shauryarchs/sprinkler-slide-pan-tilt/hardware/main-board/main-board.kicad_pcb

## KiCad design hardware/main-board/main-board.kicad_pcb (2026-11-08)

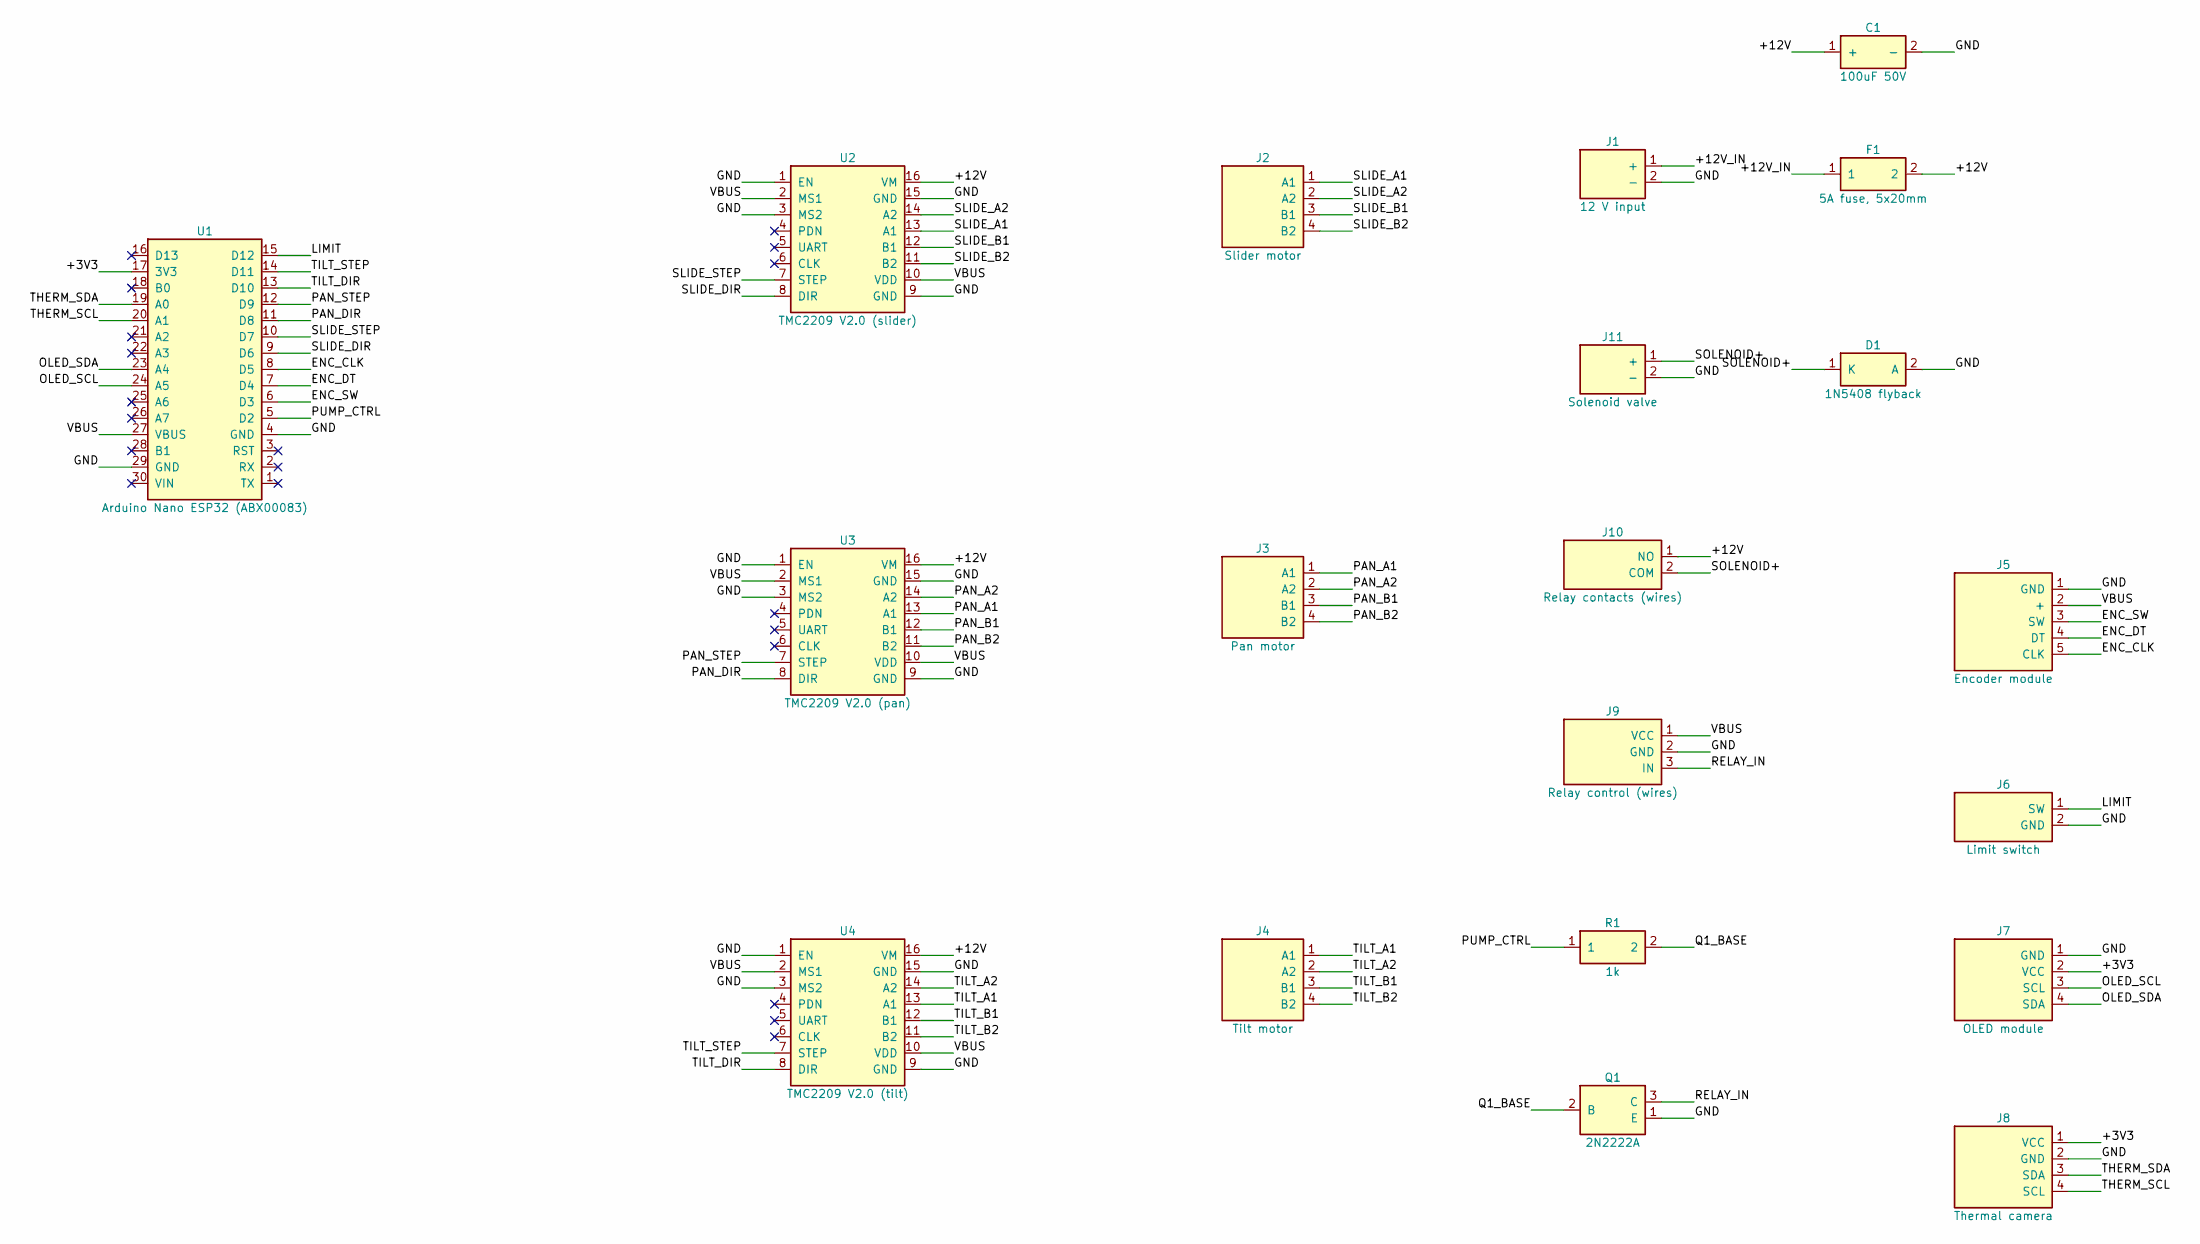
[picture p1: schematic main-board.kicad_sch, EmberSensor sprinkler rig main board]

Parts:
C1: 100uF 50V; CP_Radial_D8.0mm_P3.50mm
D1: 1N5408 flyback; D_DO-201AD_P15.24mm_Horizontal
F1: 5A fuse, 5x20mm; Fuseholder_Clip-5x20mm_Keystone_3517_Inline_P23.11x6.76mm_D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
J1: 12 V input; TerminalBlock_Phoenix_MKDS-1,5-2-5.08_1x02_P5.08mm_Horizont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
J2: Slider motor; TerminalBlock_Phoenix_MKDS-1,5-4-5.08_1x04_P5.08mm_Horizont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
J3: Pan motor; TerminalBlock_Phoenix_MKDS-1,5-4-5.08_1x04_P5.08mm_Horizont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
J4: Tilt motor; TerminalBlock_Phoenix_MKDS-1,5-4-5.08_1x04_P5.08mm_Horizont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
J5: Encoder module; PinHeader_1x05_P2.54mm_Vertical
J6: Limit switch; JST_XH_B2B-XH-A_1x02_P2.50mm_Vertical
J7: OLED module; PinHeader_1x04_P2.54mm_Vertical
J8: Thermal camera; JST_XH_B4B-XH-A_1x04_P2.50mm_Vertical
J9: Relay control (wires); PinHeader_1x03_P2.54mm_Vertical
J10: Relay contacts (wires); TerminalBlock_Phoenix_MKDS-1,5-2-5.08_1x02_P5.08mm_Horizont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
J11: Solenoid valve; TerminalBlock_Phoenix_MKDS-1,5-2-5.08_1x02_P5.08mm_Horizont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
Q1: 2N2222A; TO-92_Inline_Wide
R1: 1k; R_Axial_DIN0207_L6.3mm_D2.5mm_P10.16mm_Horizontal
U1: Arduino Nano ESP32 (ABX00083); Arduino_Nano
U2: TMC2209 V2.0 (slider); Pololu_Breakout-16_15.2x20.3mm
U3: TMC2209 V2.0 (pan); Pololu_Breakout-16_15.2x20.3mm
U4: TMC2209 V2.0 (tilt); Pololu_Breakout-16_15.2x20.3mm

Connections:
/+3V3: J7.2 (VCC), J8.1 (VCC), U1.17 (3V3)
/+12V: C1.1 (+), F1.2, J10.1 (NO), U2.16 (VM), U3.16 (VM), U4.16 (VM)
/+12V_IN: F1.1, J1.1 (+)
/ENC_CLK: J5.5 (CLK), U1.8 (D5)
/ENC_DT: J5.4 (DT), U1.7 (D4)
/ENC_SW: J5.3 (SW), U1.6 (D3)
/GND: C1.2 (-), D1.2 (A), J1.2 (-), J5.1 (GND), J6.2 (GND), J7.1 (GND), J8.2 (GND), J9.2 (GND), J11.2 (-), Q1.1 (E), U1.4 (GND), U1.29 (GND), U2.1 (EN), U2.3 (MS2), U2.9 (GND), U2.15 (GND), U3.1 (EN), U3.3 (MS2), U3.9 (GND), U3.15 (GND), U4.1 (EN), U4.3 (MS2), U4.9 (GND), U4.15 (GND)
/LIMIT: J6.1 (SW), U1.15 (D12)
/OLED_SCL: J7.3 (SCL), U1.24 (A5)
/OLED_SDA: J7.4 (SDA), U1.23 (A4)
/PAN_A1: J3.1 (A1), U3.13 (A1)
/PAN_A2: J3.2 (A2), U3.14 (A2)
/PAN_B1: J3.3 (B1), U3.12 (B1)
/PAN_B2: J3.4 (B2), U3.11 (B2)
/PAN_DIR: U1.11 (D8), U3.8 (DIR)
/PAN_STEP: U1.12 (D9), U3.7 (STEP)
/PUMP_CTRL: R1.1, U1.5 (D2)
/Q1_BASE: Q1.2 (B), R1.2
/RELAY_IN: J9.3 (IN), Q1.3 (C)
/SLIDE_A1: J2.1 (A1), U2.13 (A1)
/SLIDE_A2: J2.2 (A2), U2.14 (A2)
/SLIDE_B1: J2.3 (B1), U2.12 (B1)
/SLIDE_B2: J2.4 (B2), U2.11 (B2)
/SLIDE_DIR: U1.9 (D6), U2.8 (DIR)
/SLIDE_STEP: U1.10 (D7), U2.7 (STEP)
/SOLENOID+: D1.1 (K), J10.2 (COM), J11.1 (+)
/THERM_SCL: J8.4 (SCL), U1.20 (A1)
/THERM_SDA: J8.3 (SDA), U1.19 (A0)
/TILT_A1: J4.1 (A1), U4.13 (A1)
/TILT_A2: J4.2 (A2), U4.14 (A2)
/TILT_B1: J4.3 (B1), U4.12 (B1)
/TILT_B2: J4.4 (B2), U4.11 (B2)
/TILT_DIR: U1.13 (D10), U4.8 (DIR)
/TILT_STEP: U1.14 (D11), U4.7 (STEP)
/VBUS: J5.2 (+), J9.1 (VCC), U1.27 (VBUS), U2.2 (MS1), U2.10 (VDD), U3.2 (MS1), U3.10 (VDD), U4.2 (MS1), U4.10 (VDD)

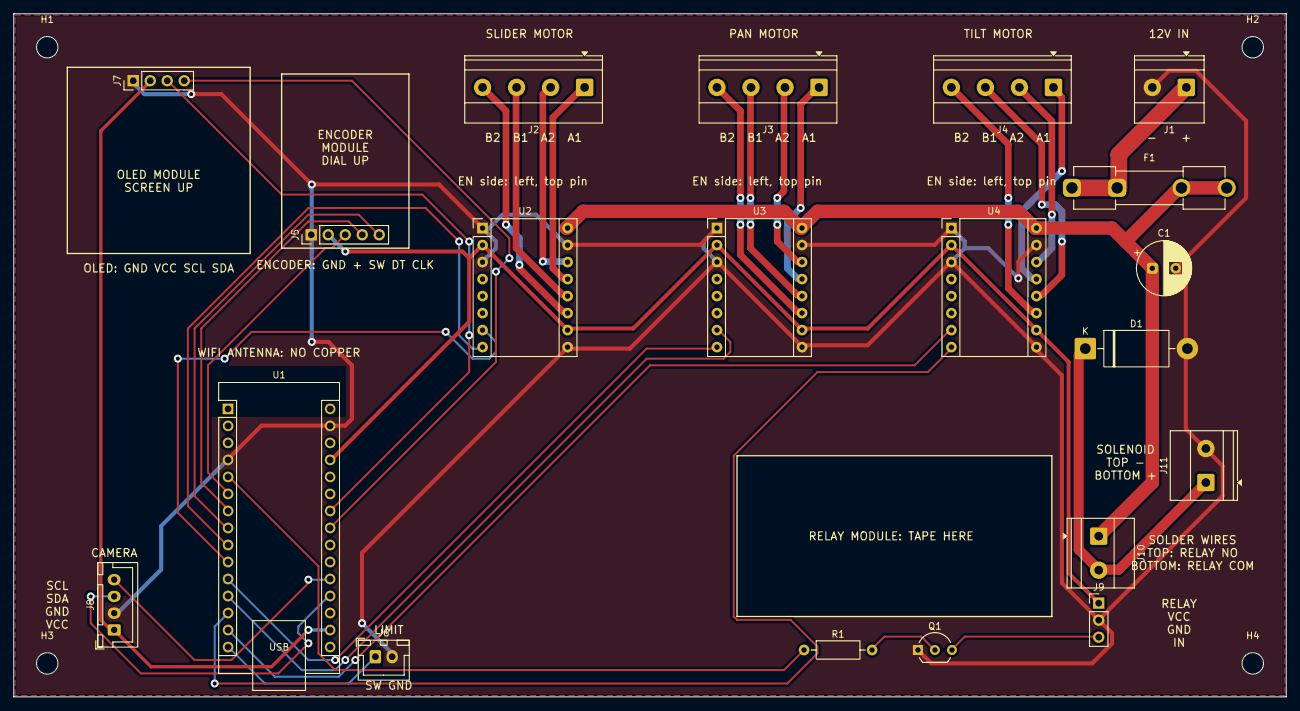
[picture p2: board main-board.kicad_pcb from above]

Board: 2 copper layers, 190.0 x 102.0 mm, 24 parts (0 on the bottom side), 35 nets.

Other parts of the board:
H1, H2, H3, H4: MountingHole_3.2mm_M3
