shauryarchs/sprinkler-slide-pan-tilt/arduino-source/main/main.ino

#include <WiFi.h>
#include <Wire.h>

#include "AppState.h"
#include "AutoAim.h"
#include "CommandPoller.h"
#include "Display.h"
#include "Encoder.h"
#include "LimitSwitch.h"
#include "PanMotor2.h"
#include "SliderMotor1.h"
#include "Sprayer.h"
#include "StatePusher.h"
#include "ThermalCamera.h"
#include "TiltMotor3.h"
#include "secrets.h"

// Pin assignments use Arduino Nano ESP32 silkscreen labels.
// The core resolves them to the right ESP32-S3 GPIOs.
namespace pins {
const int kEncoderSw = D3;
const int kEncoderDt = D4;
const int kEncoderClk = D5;
const int kMotor1Dir = D6;
const int kMotor1Step = D7;
const int kMotor2Dir = D8;
const int kMotor2Step = D9;
const int kMotor3Dir = D10;
const int kMotor3Step = D11;
const int kLimit = D12;
const int kPump = D2;  // 1 kOhm -> NPN transistor -> pump relay IN
}  // namespace pins

// display.display() blocks the main loop for ~30 ms on the I2C frame
// transfer. With timer-driven stepping the motor's pulse stream is
// unaffected by that block, so we can refresh aggressively for snappy
// dial feedback (10 fps -> ~150 ms worst-case visual lag from a click).
const unsigned long kDisplayIntervalMs = 100;

Encoder encoder(pins::kEncoderSw, pins::kEncoderDt, pins::kEncoderClk);
LimitSwitch limitSwitch(pins::kLimit);
SliderMotor1 sliderMotor1(pins::kMotor1Dir, pins::kMotor1Step);
PanMotor2 panMotor2(pins::kMotor2Dir, pins::kMotor2Step);
TiltMotor3 tiltMotor3(pins::kMotor3Dir, pins::kMotor3Step);
Display oled;
StatePusher statePusher(sliderMotor1, panMotor2, tiltMotor3, encoder, limitSwitch);
CommandPoller commandPoller;
// Thermal camera on Wire1 (A0/A1). Reports hotspots to the Serial
// Monitor only — it never moves a motor.
ThermalCamera thermalCamera(tiltMotor3);
// Thermal-guided aiming: slide first, then pan/tilt. ON at boot; acts
// only at the menu. "aim off" in the Serial Monitor disables it until reboot.
AutoAim autoAim(sliderMotor1, panMotor2, tiltMotor3, limitSwitch, thermalCamera);
// Water pump: sprays when auto-aim is on target. ON at boot; "spray off"
// in the Serial Monitor disables it until reboot.
Sprayer sprayer(pins::kPump, autoAim);

// Encoder input: pause auto-aim and stop the water. Remote commands go
// through dispatchRemoteCommand() instead, which keeps a manual spray on.
void notifyUserActivity() {
  autoAim.notifyUserActivity();
  sprayer.notifyUserActivity();
}

// Serial Monitor commands ("aim ...", "spray ...", "pump ..."), one line
// at a time, case-insensitive.
char serialLine[24];
size_t serialLineLen = 0;

void pollSerialCommands() {
  while (Serial.available()) {
    const char c = static_cast<char>(Serial.read());
    if (c != '\n' && c != '\r') {
      if (serialLineLen < sizeof(serialLine) - 1) {
        serialLine[serialLineLen++] = static_cast<char>(tolower(static_cast<unsigned char>(c)));
      }
      continue;
    }
    if (serialLineLen == 0) continue;
    serialLine[serialLineLen] = '\0';
    serialLineLen = 0;
    if (!autoAim.handleCommand(serialLine) && !sprayer.handleCommand(serialLine)) {
      Serial.println("Commands: aim on | aim off | aim status | spray on | spray off | "
                     "spray status | pump on [s] | pump off");
    }
  }
}

// UI state machine: the menu is the resting screen; selecting an item
// hands the encoder over to that motor's control logic. Short-press
// returns to the menu (and stops the active motor).
//
// The Mode enum + the `mode`, `menuIndex`, and `sliderHomed` globals
// live here (in main.ino) but are declared in AppState.h so the
// background StatePusher task can read them without a circular include.
//
// Post-boot-home modes (PanSetup, TiltSetup) are one-shot Pan/Tilt
// zero-position setup states: each click of the encoder steps the
// active motor by kSetupMicroStepsPerClick microsteps; a short-press
// locks the current position as the new "0" reference and advances.
// After Tilt setup the device drops into the menu and these states
// are never re-entered (re-home from Motor 1 does not re-prompt).
Mode mode = Mode::Menu;
int menuIndex = 0;
bool sliderHomed = false;
volatile unsigned long lastSeqAck = 0;
volatile bool pumpActive = false;
const int kMenuItemCount = 4;

// "Patrol" demo mode. The slider and pan motors bounce between their
// soft floor and ceiling; the tilt motor stays put and is only moved
// by the calibration nudgeTilt / zeroTilt commands. The slider's
// speed is driven by the encoder dial — magnitude only, so spinning
// either way speeds it up and dial=0 parks it. Pan has its own
// per-motor magnitude that defaults to 6 and can be retuned at
// runtime by the website via setAllMotorsPanSpeed. Speeds are on
// the dial's [0, kEncoderRange] scale.
int allMotorsPanSpeed = 6;
// Slider speed setpoint applied to the encoder dial on Patrol entry,
// so the carriage starts moving as soon as the user selects the mode
// instead of sitting at zero until they spin the dial.
constexpr int kPatrolInitialSliderSpeed = 18;
// Bounce state per motor in Patrol mode. +1 = heading toward the
// soft ceiling, -1 = heading toward the soft floor.
int allMotorsSliderDir = 1;
int allMotorsPanDir = 1;

// Microsteps applied per encoder click during PanSetup/TiltSetup. The
// motors run at 6400 microsteps/rev = 17.78 microsteps/° with a 1:1
// shaft coupling, so 18 microsteps ≈ 1° per click.
const int kSetupMicroStepsPerClick = 18;

unsigned long lastDisplayUpdateMs = 0;

void enterMenu() {
  sliderMotor1.stop();
  panMotor2.stop();
  tiltMotor3.stop();
  encoder.reset();
  encoder.syncSwState();  // suppress long-press from the press that got us here
  mode = Mode::Menu;
  lastDisplayUpdateMs = 0;
}

void enterMotor1() {
  encoder.reset();
  encoder.syncSwState();
  mode = Mode::Motor1Control;
  lastDisplayUpdateMs = 0;
}

void enterMotor2() {
  encoder.reset();
  encoder.syncSwState();
  mode = Mode::Motor2Control;
  lastDisplayUpdateMs = 0;
}

void enterMotor3() {
  encoder.reset();
  encoder.syncSwState();
  mode = Mode::Motor3Control;
  lastDisplayUpdateMs = 0;
}

void enterAllMotors() {
  encoder.reset();
  // Seed the dial so the slider starts moving immediately. The Patrol
  // handler reads encoder.position() as the slider speed magnitude, so
  // setting it post-reset gives a non-zero starting speed. The user
  // can spin the dial — or the website slider — to override at any
  // time.
  encoder.set(kPatrolInitialSliderSpeed);
  encoder.syncSwState();
  // Pick a starting direction for each bouncing motor that doesn't
  // stall against the ceiling on entry — if already at the ceiling,
  // head back. Tilt doesn't bounce in Patrol mode, so no direction
  // for it.
  allMotorsSliderDir =
      (sliderMotor1.positionSteps() >= SliderMotor1::kMaxPositionSteps) ? -1 : 1;
  allMotorsPanDir =
      (panMotor2.positionSteps() >= PanMotor2::kMaxPositionSteps) ? -1 : 1;
  mode = Mode::AllMotorsControl;
  lastDisplayUpdateMs = 0;
}

// Home the slider, then park the carriage at the middle of the rail so the
// thermal camera can see both sides. Blocking (~16 s for the park move).
void homeAndCenterSlider() {
  oled.showHomingMessage();
  sliderMotor1.home(limitSwitch);
  sliderMotor1.moveToBlocking(SliderMotor1::kCenterPositionSteps, limitSwitch);
  sliderHomed = true;
}

void rehome() {
  // Long-press in Motor1 mode re-homes. Drop the encoder ISR for the
  // duration of homing, then resync after.
  encoder.suspend();
  homeAndCenterSlider();
  encoder.reset();
  encoder.resume();
  encoder.syncSwState();
  lastDisplayUpdateMs = 0;
}

void setup() {
  // USB serial for the thermal camera's "THERMAL ..." status lines.
  // Printing happens on the core-0 thermal task, never the motor loop.
  Serial.begin(115200);
  sprayer.begin();  // pump off before anything else

  limitSwitch.begin();
  sliderMotor1.begin();
  panMotor2.begin();
  tiltMotor3.begin();

  Wire.begin();
  Wire.setClock(400000);
  oled.begin();

  // Motor1 boot homing (then park at the middle of the rail); motor2 has
  // no limit switch so we just trust its mechanical alignment at power-on.
  homeAndCenterSlider();

  encoder.begin();
  encoder.syncSwState();

  // Start Wi-Fi in station mode and kick off the background state-push
  // task. Wi-Fi connect is non-blocking — if the network is down the
  // device keeps working locally; StatePusher's pushOnce() short-circuits
  // when WiFi.status() != WL_CONNECTED, and the next heartbeat just
  // tries again.
  WiFi.mode(WIFI_STA);
  WiFi.begin(WIFI_SSID, WIFI_PASSWORD);
  statePusher.begin(EMBER_API_HOST);
  commandPoller.begin(EMBER_API_HOST);
  thermalCamera.begin();

  // After boot homing, prompt the user to set the Pan and Tilt initial
  // positions before handing control over to the main menu. This runs
  // once per power-up; re-homing later (long-press in Motor 1) does not
  // re-enter setup.
  mode = Mode::PanSetup;
}

void handleMenu() {
  int delta = encoder.consumeDelta();
  if (delta != 0) {
    notifyUserActivity();
    int step = (delta > 0) ? 1 : -1;
    menuIndex = (menuIndex + step + kMenuItemCount) % kMenuItemCount;
  }
  if (encoder.consumeShortPress()) {
    notifyUserActivity();
    switch (menuIndex) {
      case 0: enterMotor1(); break;
      case 1: enterMotor2(); break;
      case 2: enterMotor3(); break;
      case 3: enterAllMotors(); break;
    }
  }
  // Long-press has no meaning in the menu — drain it so it doesn't
  // fire later in motor mode if the user held through the transition.
  encoder.consumeLongPress();
}

void handleMotor1() {
  if (encoder.consumeShortPress()) {
    enterMenu();
    return;
  }
  if (encoder.consumeLongPress()) {
    rehome();
    return;
  }

  int dial = encoder.position();
  sliderMotor1.update(dial, limitSwitch);

  // Auto-reset the dial when pinned at an end of travel so the next
  // click in the opposite direction goes straight into reverse.
  long posSteps = sliderMotor1.positionSteps();
  if (dial > 0 && posSteps >= SliderMotor1::kMaxPositionSteps) {
    encoder.reset();
  } else if (dial < 0 && posSteps <= SliderMotor1::kMinPositionSteps) {
    encoder.reset();
  }
}

void handleMotor2() {
  if (encoder.consumeShortPress()) {
    enterMenu();
    return;
  }
  // Long-press is meaningful only on motor1 — drain it.
  encoder.consumeLongPress();

  int dial = encoder.position();
  panMotor2.update(dial);

  // Same auto-reset idea: at either end of the ±105° range, snap the
  // dial back to 0 so reversing is one click away.
  long posSteps = panMotor2.positionSteps();
  if (dial > 0 && posSteps >= PanMotor2::kMaxPositionSteps) {
    encoder.reset();
  } else if (dial < 0 && posSteps <= PanMotor2::kMinPositionSteps) {
    encoder.reset();
  }
}

void handleMotor3() {
  if (encoder.consumeShortPress()) {
    enterMenu();
    return;
  }
  encoder.consumeLongPress();

  int dial = encoder.position();
  tiltMotor3.update(dial);

  long posSteps = tiltMotor3.positionSteps();
  if (dial > 0 && posSteps >= TiltMotor3::kMaxPositionSteps) {
    encoder.reset();
  } else if (dial < 0 && posSteps <= TiltMotor3::kMinPositionSteps) {
    encoder.reset();
  }
}

void handleAllMotors() {
  if (encoder.consumeShortPress()) {
    enterMenu();
    return;
  }
  // Long-press is unused in this mode — drain so a hold-through-entry
  // doesn't fire later.
  encoder.consumeLongPress();

  // Encoder dial controls the slider's speed magnitude only; the bounce
  // direction is managed below. dial=0 parks the slider; spinning either
  // way speeds it up.
  int dial = encoder.position();
  int sliderSpeed = (dial >= 0) ? dial : -dial;

  // Slider: bounce. Flip direction once the carriage reaches either
  // soft bound; the motor's own update() will already have stopped it
  // there, and the next loop iteration will start it moving back.
  long sliderPos = sliderMotor1.positionSteps();
  if (allMotorsSliderDir > 0 && sliderPos >= SliderMotor1::kMaxPositionSteps) {
    allMotorsSliderDir = -1;
  } else if (allMotorsSliderDir < 0 && sliderPos <= SliderMotor1::kMinPositionSteps) {
    allMotorsSliderDir = 1;
  }
  sliderMotor1.update(allMotorsSliderDir * sliderSpeed, limitSwitch);

  // Pan: bounce between ±105° around the boot reference.
  long panPos = panMotor2.positionSteps();
  if (allMotorsPanDir > 0 && panPos >= PanMotor2::kMaxPositionSteps) {
    allMotorsPanDir = -1;
  } else if (allMotorsPanDir < 0 && panPos <= PanMotor2::kMinPositionSteps) {
    allMotorsPanDir = 1;
  }
  panMotor2.update(allMotorsPanDir * allMotorsPanSpeed);

  // Tilt is intentionally not driven in Patrol mode — it stays put,
  // and is moved only by the calibration nudgeTilt / zeroTilt commands.
}

void handlePanSetup() {
  if (encoder.consumeShortPress()) {
    panMotor2.zeroPosition();
    encoder.reset();
    encoder.syncSwState();
    mode = Mode::TiltSetup;
    lastDisplayUpdateMs = 0;
    return;
  }
  // Long-press has no meaning in setup — drain it.
  encoder.consumeLongPress();

  int delta = encoder.consumeDelta();
  if (delta != 0) {
    panMotor2.stepBy(delta * kSetupMicroStepsPerClick);
  }
}

void handleTiltSetup() {
  if (encoder.consumeShortPress()) {
    tiltMotor3.zeroPosition();
    encoder.reset();
    encoder.syncSwState();
    mode = Mode::Menu;
    lastDisplayUpdateMs = 0;
    return;
  }
  encoder.consumeLongPress();

  int delta = encoder.consumeDelta();
  if (delta != 0) {
    tiltMotor3.stepBy(delta * kSetupMicroStepsPerClick);
  }
}

// Dispatch a command delivered by CommandPoller into the same handlers
// the encoder uses. Runs only on the main loop thread, so it can freely
// touch `mode`, the encoder ISR, etc.
//
// Conflict policy is last-write-wins: a remote `enterMode` takes effect
// immediately even if the user is mid-spin; the next encoder click
// would just transition again. setSliderSpeed re-anchors the encoder
// dial, which the Patrol handler reads on each iteration. We
// intentionally ignore PanSetup / TiltSetup target modes — that flow
// is one-shot at boot and not exposed to the remote.
void dispatchRemoteCommand(const RemoteCommand& cmd) {
  // Any remote command takes priority over auto-aim and stops automatic
  // spraying. A manual spray keeps going so the user can aim while it
  // runs; only pumpOff or Stop (enterMode menu) ends it early.
  autoAim.notifyUserActivity();
  sprayer.notifyRemoteCommand();
  switch (cmd.kind) {
    case RemoteCmdKind::EnterMode:
      switch (cmd.targetMode) {
        case Mode::Menu:
          // The app's and website's Stop button: stop motors and water.
          sprayer.remoteStop();
          enterMenu();
          break;
        case Mode::Motor1Control:    enterMotor1();    break;
        case Mode::Motor2Control:    enterMotor2();    break;
        case Mode::Motor3Control:    enterMotor3();    break;
        case Mode::AllMotorsControl: enterAllMotors(); break;
        default: break;
      }
      break;
    case RemoteCmdKind::Rehome:
      // rehome() suspends the encoder ISR, homes the slider, resumes.
      // Safe to call from any mode; current mode is preserved.
      rehome();
      break;
    case RemoteCmdKind::ZeroPan:
      panMotor2.zeroPosition();
      break;
    case RemoteCmdKind::ZeroTilt:
      tiltMotor3.zeroPosition();
      break;
    case RemoteCmdKind::NudgePan: {
      // Convert signed degrees → microsteps; same math as
      // kSetupMicroStepsPerClick uses. stepBy() bypasses soft bounds
      // — intentional, this mirrors PanSetup mode behavior.
      const long steps =
          (static_cast<long>(cmd.deltaDeg) * PanMotor2::kStepsPerRev) / 360;
      panMotor2.stepBy(static_cast<int>(steps));
      break;
    }
    case RemoteCmdKind::NudgeTilt: {
      const long steps =
          (static_cast<long>(cmd.deltaDeg) * TiltMotor3::kStepsPerRev) / 360;
      tiltMotor3.stepBy(static_cast<int>(steps));
      break;
    }
    case RemoteCmdKind::SetSliderSpeed:
      // The encoder dial is the speed setpoint in every motor mode:
      // signed (sign = direction) for Motor 1/2/3, magnitude for
      // Patrol (direction is the bounce). Re-anchor in all four
      // so the website's signed speed slider works across them.
      // Menu / PanSetup / TiltSetup use the encoder as a navigation
      // delta or a setup nudge, so re-anchoring there would just
      // surprise the user.
      if (mode == Mode::Motor1Control || mode == Mode::Motor2Control ||
          mode == Mode::Motor3Control || mode == Mode::AllMotorsControl) {
        encoder.set(cmd.speed);
      }
      break;
    case RemoteCmdKind::SetAllMotorsPanSpeed:
      // Magnitude only — direction is set by the bounce logic in
      // handleAllMotors(). Clamp to the encoder's positive range so a
      // bad payload can't push the motor past its max step rate.
      allMotorsPanSpeed = constrain(cmd.speed, 0, Encoder::kRange);
      break;
    case RemoteCmdKind::PumpOn:
      // Timed manual run; Sprayer caps it at kRemoteMaxS.
      sprayer.remoteStart(cmd.seconds);
      break;
    case RemoteCmdKind::PumpOff:
      sprayer.remoteStop();
      break;
    default:
      break;
  }
  lastSeqAck = cmd.seq;
}

void loop() {
  encoder.update();
  pollSerialCommands();

  // Drain any commands the CommandPoller task has queued. Bounded by
  // the queue depth (4); typically 0 or 1 per iteration.
  RemoteCommand cmd;
  while (xQueueReceive(commandPoller.queue(), &cmd, 0) == pdTRUE) {
    dispatchRemoteCommand(cmd);
  }

  switch (mode) {
    case Mode::Menu:             handleMenu();      break;
    case Mode::Motor1Control:    handleMotor1();    break;
    case Mode::Motor2Control:    handleMotor2();    break;
    case Mode::Motor3Control:    handleMotor3();    break;
    case Mode::AllMotorsControl: handleAllMotors(); break;
    case Mode::PanSetup:         handlePanSetup();  break;
    case Mode::TiltSetup:        handleTiltSetup(); break;
  }

  // Auto-aim only acts while idle at the menu; motor modes and the boot
  // setup screens own the motors.
  autoAim.update(mode == Mode::Menu);
  sprayer.update();
  pumpActive = sprayer.pumpOn();

  if (millis() - lastDisplayUpdateMs >= kDisplayIntervalMs) {
    switch (mode) {
      case Mode::Menu:
        oled.showMenu(menuIndex);
        break;
      case Mode::Motor1Control:
        oled.showMotor1Status(encoder.position(), sliderMotor1.positionMm(),
                              limitSwitch.engaged());
        break;
      case Mode::Motor2Control:
        oled.showMotor2Status(encoder.position(), panMotor2.positionDegrees());
        break;
      case Mode::Motor3Control:
        oled.showMotor3Status(encoder.position(), tiltMotor3.positionDegrees());
        break;
      case Mode::AllMotorsControl: {
        int dial = encoder.position();
        int sliderSpeed = (dial >= 0) ? dial : -dial;
        oled.showAllMotorsStatus(sliderSpeed,
                                 sliderMotor1.positionMm(),
                                 panMotor2.positionDegrees(),
                                 tiltMotor3.positionDegrees(),
                                 limitSwitch.engaged());
        break;
      }
      case Mode::PanSetup:
        oled.showPanSetupScreen(panMotor2.positionDegrees());
        break;
      case Mode::TiltSetup:
        oled.showTiltSetupScreen(tiltMotor3.positionDegrees());
        break;
    }
    lastDisplayUpdateMs = millis();
  }
}
