shauryarchs/sprinkler-slide-pan-tilt/arduino-source/main/AppState.h

#pragma once

// Application-level state shared between main.ino and StatePusher.
//
// main.ino is the single writer for `mode`, `menuIndex`, and
// `sliderHomed`. StatePusher reads them from its background task. On
// the ESP32-S3, single-word loads of plain integer/enum types are
// atomic across cores, so we don't need a mutex around these reads —
// the reader may see a slightly stale value for one tick, which is
// fine for a state-mirror push.

enum class Mode {
  Menu,
  Motor1Control,
  Motor2Control,
  Motor3Control,
  AllMotorsControl,
  PanSetup,
  TiltSetup,
};

extern Mode mode;
extern int menuIndex;
extern bool sliderHomed;

// Sequence number of the last /api/motor/command the device executed.
// CommandPoller passes this as ?since=<lastSeqAck> when polling so the
// worker only returns newer commands. StatePusher echoes it in its
// push JSON so the website can show "Done" feedback once a command
// has been picked up. Read on core 0 (network task) and written by
// the main loop on core 1; volatile + single-word atomic loads
// suffice.
extern volatile unsigned long lastSeqAck;

// Whether the water pump is running (automatic or manual). Written by
// the main loop after sprayer.update(), read by StatePusher so the app
// can show when water is flowing.
extern volatile bool pumpActive;

// Stable lowercase machine-readable names the website's control page
// keys off (see docs/control.html → MODE_LABELS).
inline const char* modeName(Mode m) {
  switch (m) {
    case Mode::Menu:             return "menu";
    case Mode::Motor1Control:    return "motor1";
    case Mode::Motor2Control:    return "motor2";
    case Mode::Motor3Control:    return "motor3";
    case Mode::AllMotorsControl: return "allmotors";
    case Mode::PanSetup:         return "panSetup";
    case Mode::TiltSetup:        return "tiltSetup";
  }
  return "unknown";
}
