shauryarchs/sprinkler-slide-pan-tilt/arduino-source/main/Display.cpp

#include "Display.h"

namespace {
constexpr int kScreenWidth = 128;
constexpr int kScreenHeight = 64;
}  // namespace

Display::Display(uint8_t addr)
    : display_(kScreenWidth, kScreenHeight, &Wire, -1),
      addr_(addr),
      ok_(false) {}

bool Display::begin() {
  ok_ = display_.begin(SSD1306_SWITCHCAPVCC, addr_);
  if (ok_) {
    display_.clearDisplay();
    display_.setTextColor(SSD1306_WHITE);
  }
  return ok_;
}

void Display::showHomingMessage() {
  if (!ok_) return;
  display_.clearDisplay();
  display_.setTextColor(SSD1306_WHITE);
  display_.setTextSize(2);
  display_.setCursor(0, 0);
  display_.println(F("Homing..."));
  display_.setTextSize(1);
  display_.setCursor(0, 22);
  display_.println(F("Please wait,"));
  display_.setCursor(0, 34);
  display_.println(F("don't press any"));
  display_.setCursor(0, 46);
  display_.println(F("buttons or dials"));
  display_.display();
}

void Display::showMenu(int selection) {
  if (!ok_) return;
  display_.clearDisplay();
  display_.setTextColor(SSD1306_WHITE);
  display_.setTextSize(1);

  display_.setCursor(0, 0);
  display_.println(F("Select Motor:"));

  // Size 1 (6x8 px). Longer names don't fit at size 2 — "> Slider-Motor1"
  // is 15 chars × 12 px = 180 px, well past the 128 px panel. Row pitch
  // tightened to 12 px to fit four items inside the 64 px panel.
  display_.setCursor(0, 14);
  display_.print(selection == 0 ? F("> Slider-Motor1") : F("  Slider-Motor1"));
  display_.setCursor(0, 26);
  display_.print(selection == 1 ? F("> Pan-Motor2") : F("  Pan-Motor2"));
  display_.setCursor(0, 38);
  display_.print(selection == 2 ? F("> Tilt-Motor3") : F("  Tilt-Motor3"));
  display_.setCursor(0, 50);
  display_.print(selection == 3 ? F("> Patrol") : F("  Patrol"));

  display_.display();
}

void Display::showMotor1Status(int dial, long posMm, bool limitEngaged) {
  if (!ok_) return;
  display_.clearDisplay();
  display_.setTextColor(SSD1306_WHITE);
  display_.setTextSize(1);

  display_.setCursor(0, 0);
  display_.println(F("Ember Sensor"));

  display_.setCursor(0, 10);
  display_.println(F("www.embersensor.com"));

  display_.setCursor(0, 22);
  display_.print(F("Dial: "));
  if (dial > 0) display_.print('+');
  display_.print(dial);
  display_.print(' ');
  if (dial > 0) display_.print(F("CW"));
  else if (dial < 0) display_.print(F("CCW"));
  else display_.print(F("STOP"));

  display_.setCursor(0, 33);
  display_.print(F("Pos: "));
  display_.print(posMm);
  display_.print(F(" mm"));

  display_.setCursor(0, 44);
  display_.print(F("Limit: "));
  display_.print(limitEngaged ? F("LOW (hit)") : F("HIGH"));

  display_.setCursor(0, 56);
  display_.print(F("By, Shaurya Varshnay"));

  display_.display();
}

void Display::showMotor2Status(int dial, long posDeg) {
  if (!ok_) return;
  display_.clearDisplay();
  display_.setTextColor(SSD1306_WHITE);
  display_.setTextSize(1);

  display_.setCursor(0, 0);
  display_.println(F("Ember Sensor"));

  display_.setCursor(0, 10);
  display_.println(F("www.embersensor.com"));

  display_.setCursor(0, 22);
  display_.print(F("Dial: "));
  if (dial > 0) display_.print('+');
  display_.print(dial);
  display_.print(' ');
  if (dial > 0) display_.print(F("CW"));
  else if (dial < 0) display_.print(F("CCW"));
  else display_.print(F("STOP"));

  display_.setCursor(0, 33);
  display_.print(F("Pos: "));
  display_.print(posDeg);
  display_.print(F(" deg"));

  display_.setCursor(0, 44);
  display_.print(F("Pan-Motor2 [+/-105]"));

  display_.setCursor(0, 56);
  display_.print(F("By, Shaurya Varshnay"));

  display_.display();
}

void Display::showMotor3Status(int dial, long posDeg) {
  if (!ok_) return;
  display_.clearDisplay();
  display_.setTextColor(SSD1306_WHITE);
  display_.setTextSize(1);

  display_.setCursor(0, 0);
  display_.println(F("Ember Sensor"));

  display_.setCursor(0, 10);
  display_.println(F("www.embersensor.com"));

  display_.setCursor(0, 22);
  display_.print(F("Dial: "));
  if (dial > 0) display_.print('+');
  display_.print(dial);
  display_.print(' ');
  if (dial > 0) display_.print(F("CW"));
  else if (dial < 0) display_.print(F("CCW"));
  else display_.print(F("STOP"));

  display_.setCursor(0, 33);
  display_.print(F("Pos: "));
  display_.print(posDeg);
  display_.print(F(" deg"));

  display_.setCursor(0, 44);
  display_.print(F("Tilt-Motor3 [+/-360]"));

  display_.setCursor(0, 56);
  display_.print(F("By, Shaurya Varshnay"));

  display_.display();
}

namespace {
void renderSetupScreen(Adafruit_SSD1306& display_, const __FlashStringHelper* title,
                       long offsetDeg) {
  display_.clearDisplay();
  display_.setTextColor(SSD1306_WHITE);
  display_.setTextSize(1);

  display_.setCursor(0, 0);
  display_.println(title);

  display_.setCursor(0, 14);
  display_.println(F("Spin to rotate"));

  display_.setCursor(0, 26);
  display_.println(F("Press to set 0"));

  display_.setCursor(0, 44);
  display_.print(F("Offset: "));
  if (offsetDeg > 0) display_.print('+');
  display_.print(offsetDeg);
  display_.print(F(" deg"));

  display_.setCursor(0, 56);
  display_.print(F("By, Shaurya Varshnay"));

  display_.display();
}
}  // namespace

void Display::showPanSetupScreen(long offsetDeg) {
  if (!ok_) return;
  renderSetupScreen(display_, F("Set Pan Start"), offsetDeg);
}

void Display::showTiltSetupScreen(long offsetDeg) {
  if (!ok_) return;
  renderSetupScreen(display_, F("Set Tilt Start"), offsetDeg);
}

void Display::showAllMotorsStatus(int sliderSpeed, long sliderMm, long panDeg,
                                  long tiltDeg, bool limitEngaged) {
  if (!ok_) return;
  display_.clearDisplay();
  display_.setTextColor(SSD1306_WHITE);
  display_.setTextSize(1);

  display_.setCursor(0, 0);
  display_.println(F("Patrol"));

  display_.setCursor(0, 12);
  display_.print(F("Slider: "));
  display_.print(sliderMm);
  display_.print(F(" mm"));

  display_.setCursor(0, 22);
  display_.print(F("Pan:    "));
  display_.print(panDeg);
  display_.print(F(" deg"));

  display_.setCursor(0, 32);
  display_.print(F("Tilt:   "));
  display_.print(tiltDeg);
  display_.print(F(" deg"));

  display_.setCursor(0, 44);
  display_.print(F("Spd: "));
  display_.print(sliderSpeed);
  display_.print(F("  Lmt: "));
  display_.print(limitEngaged ? F("LOW") : F("HI"));

  display_.setCursor(0, 56);
  display_.print(F("By, Shaurya Varshnay"));

  display_.display();
}
