shauryarchs/sprinkler-slide-pan-tilt/(commit log)

2026-04-26 added arduino source for testing
2026-04-26 Add I2C scanner sketch for diagnosing OLED bus issues
2026-04-26 Add button (D4/D5/D6) and pot (A0) motor controls
    - Three buttons with INPUT_PULLUP and 30 ms debounce: D4 CCW, D5 CW, D6 stop
    - Pot on A0 drives speed and direction when motor is IDLE; 25-count deadband
    - Mid-spin direction reversals re-ramp to avoid losing steps
    - Display shows POT/SMOOTH/DANCE/IDLE with speed bar and CW/CCW indicator
    - Boot prints initial button pin states to surface miswiring early
    - OLED redraws throttled to ~10 fps during pot sliding to spare I2C bandwidth
    [main.ino]
2026-04-26 Document button colors in wiring header (D4 blue, D5 green, D6 red)
2026-04-26 Convert pot to positional encoder (1° pot = 1° motor) and add doggy idle art
    - Pot now reports a signed step delta per poll instead of a velocity target;
    motor steps once per delta, so turning the knob rotates the motor 1:1 in
    degrees and stopping the knob stops the motor
    - Pot is still active only when motor is IDLE; setMode() resyncs the pot's
    reference on entry to IDLE so the motor doesn't lurch to catch up with
    pot movement that happened during SMOOTH/DANCE
    - Calibration constants (POT_USABLE_DEG, MOTOR_STEPS_PER_REV) at the top
    of pot.cpp for hardware tuning
    - Display POT screen shows 'synced to knob' subtitle (no longer a speed
    bar — doesn't apply to position tracking)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
    [main.ino]
2026-04-26 Add running dog animation, 10x pot range, 3x smooth speed, THEO label
    - Display: 4-frame running-dog ASCII animation (~7 fps) plays whenever the
    motor is rotating (SMOOTH/DANCE/POT). IDLE keeps the static dog.
    - IDLE label renamed to THEO.
    - Pot: STEPS_PER_FULL_POT 200 -> 2000, so a full knob turn drives ten
    motor revolutions instead of one. Conversion simplified to use the
    step count directly (no degree math). Wiring header updated.
    - Smooth: SMOOTH_DEFAULT_DELAY_US 700 -> 233 us, tripling the default
    CW/CCW step rate.
2026-04-26 Stop pot motor immediately when knob stops turning
    Process pot delta in small batches (8 steps) and re-poll between them
    instead of committing the full delta to a tight step loop. When the pot
    goes stationary, the next pollDelta returns 0 and runPot exits — the
    motor stops within ~one batch (~8 ms) of the user releasing the knob
    instead of running off the remaining backlog. Trade-off: a very fast
    knob sweep can leave the motor a few steps behind the pot's final
    position, since we explicitly do not chase the residual.
2026-04-26 Make STOP button override pot tracking with a latch
    Previously pressing STOP while the pot was driving the motor was a
    no-op (mode was already IDLE). Now STOP latches a potDisabled flag that
    runPot checks each iteration, so the motor stops within one batch
    regardless of whether SMOOTH/DANCE or pot tracking caused the motion.
    - Motor::stopPressed() halts and sets the latch; pressing STOP again
    while already idle toggles the latch back off so the pot can be
    re-engaged without going through SMOOTH first
    - Motor::startSmooth() clears the latch (CW/CCW is an explicit start)
    - Display shows STOP instead of THEO when the latch is on
    - Both serial 's' and the red button route through stopPresse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
2026-04-27 Switch smooth mode to single-interval pulse timing
    - Replace half-period delay + ramp-up with one full-period interval
    - Drop unused setMode() from public Motor API
    - Update comments to reflect TB6600 driver wiring
    [main.ino]
2026-04-27 Add joystick Y-axis control with deflection-based speed
    - New joystick module reads A0, emits up/down/center events with deadband
    - Joystick mirrors CW/CCW/STOP buttons for direction
    - Deflection magnitude maps to step interval via Motor::setSpeedFraction
    - Light push = slow, full push = fast; centered stick leaves speed alone
2026-05-09 Add TMC2209 stepper slider sketch with pot, OLED, and limit-switch homing
2026-05-09 Move DIR/STEP pins to D6/D7 to free interrupt pins D2/D3
2026-05-09 Add motor 2 oscillator on D8/D9 sweeping 0-180 degrees, paused by D10 button
    [first-motor.ino]
2026-05-09 Revert "Add motor 2 oscillator on D8/D9 sweeping 0-180 degrees, paused by D10 button"
    This reverts commit 5b20a6c2933ec91f9fd91605f0df53b5217fbec3.
    [first-motor.ino]
2026-05-13 Replace pot/LED/pause-button with KY-040 encoder; SW jogs CW at homing speed
    Pinout changes:
    - ENCODER_SW=D3, ENCODER_DT=D4, ENCODER_CLK=D5 (DT/CLK declared, unused)
    - LIMIT_PIN moved from D4 to D10
    - LED_PIN/BUTTON_PIN/POT_PIN removed
    Behavior:
    - Holding the encoder switch jogs the carriage CW at HOMING_STEP_INTERVAL_US
    using the same direct-pulse routine as the homing path
    - Stepping is now loop-driven via micros() timing; hardware timer ISR,
    portMUX, pot smoothing buffer, ramp helper, and auto-reverse logic are
    all gone
    - Max travel extended to 1000 mm; CW edge stop preserved
    - OLED shows Idle/Jog CW state, position in mm, and limit switch state
    [first-motor.ino]
2026-05-13 Drive motor speed and direction from KY-040 dial position
    Encoder dial maps to a signed setpoint in [-20, +20]: sign picks direction
    (positive = CW, negative = CCW), magnitude scales the step interval
    linearly from 3000 us at |dial|=1 down to 120 us at |dial|=20. Dial at 0
    stops the motor. SW press resets the dial to 0 for an immediate stop.
    Encoder reading is interrupt-driven on ENCODER_CLK falling edge with a
    1.5 ms software debounce; running off an ISR keeps detents from being
    dropped during the ~30 ms OLED I2C transfer. The ISR is attached after
    homing so dial spins during the homing phase are ignored.
    OLED now shows the signed dial value with direction label and the
    target speed in mm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
    [first-motor.ino]
2026-05-14 Fix step-pulse starvation, home-switch rest, and encoder reset race
    - Bump displayInterval from 100 ms to 250 ms; the ~30 ms blocking
    display.display() call was consuming ~30% of stepping time and
    causing audible jitter at high dial values.
    - Back off the carriage after homing until the limit switch releases,
    plus 80 microsteps (~0.5 mm) of clearance, before zeroing position.
    Prevents the switch from re-tripping on drift.
    - Wrap encoderPos reset in noInterrupts()/interrupts() so the ISR
    can't interleave a read-modify-write with the store from the SW
    press handler.
    [first-motor.ino]
2026-05-14 Add long-press re-home, two-pass homing, OLED fallback, misc cleanup
    - Long-press SW (>=1.5 s) now triggers a full re-home; short press still
    acts as an immediate stop. Detaches the encoder ISR during the rehome
    to ignore dial spins, then re-zeros encoderPos under a critical section.
    - Two-pass homing: fast CCW approach, back off past the switch, slow CCW
    re-engage for an accurate trip point, final back off with clearance.
    Reduces switch wear and improves home repeatability.
    - Widen drift-recovery window from 200 to 1600 steps (~10 mm). Larger
    CCW limit-trip discrepancies are left alone so they must be resolved
    by an explicit re-home rather than silently re-zeroing the counter.
    -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
    [first-motor.ino]
2026-05-14 Robustness pass: SW init, position rounding, wider home back-off
    - Sync encSwState to the actual SW pin at the end of setup() so a user
    who is holding the button through boot doesn't get registered as a
    falling edge on the first loop iteration and trip an unwanted long-
    press re-home 1.5 s later.
    - Round stepperPosition to the nearest mm in the display (159 steps =
    0.99 mm now reads as 1, not 0).
    - Bump HOMING_BACKOFF_STEPS from 80 to 160 (~0.5 mm -> ~1 mm). The old
    margin was tight enough that switch hysteresis or small play could
    re-trip the limit.
    - Add static_asserts on the interval, position and encoder constants
    so a future bad edit fails at compile time instead of silent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
    [first-motor.ino]
2026-05-14 Rename first-motor sketch to main and move into arduino-source/main
    Arduino IDE expects the .ino filename to match its parent folder, so
    arduino-source/main/main.ino is the canonical location for this sketch.
2026-05-14 Refactor sketch into per-component classes
    Split the single-file sketch into one class per hardware component, with
    main.ino reduced to instantiation and orchestration. Behavior is intended
    to be equivalent to the prior single-file version.
    New modules (sketch-folder .h/.cpp pairs, all compiled into the sketch):
    - LimitSwitch: pull-up + engaged() reader for the home switch.
    - StatusLed: non-blocking 1 Hz heartbeat for the onboard LED.
    - Display: SSD1306 wrapper; tracks begin() success and no-ops UI calls
    when the OLED is absent.
    - Encoder: KY-040 driver with a static IRAM_ATTR trampoline that
    dispatches to the singleton instance. Owns SW debounce, short-press
    (immediate stop) and long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
    [Display.cpp, Display.h, Encoder.cpp, Encoder.h, LimitSwitch.cpp, LimitSwitch.h, Stepper.cpp, Stepper.h]
2026-05-14 Remove StatusLed component
    The board no longer has the onboard LED wired up for status indication,
    so the heartbeat-on-OLED-missing path is dead weight. Delete StatusLed.h
    and StatusLed.cpp, and remove the instance, begin(), setBlinking() and
    update() calls from main.ino. The OLED-missing fallback still works —
    Display::showStatus() and showHomingMessage() are no-ops when begin()
    reports failure, so the motor keeps running without any UI.
    [main.ino]
2026-05-14 Move step pulse generation to a hardware-timer ISR
    Previously, step pulses were issued from the main loop. The 250 ms
    display refresh interval calls Adafruit_SSD1306::display(), which
    blocks on the ~1 KiB I2C frame transfer for ~30 ms. During those
    30 ms no pulses were emitted, so the motor experienced a 30 ms
    cadence gap every 250 ms — an instant decel to 0 and back to max,
    audible jerk at high speeds and capable of causing missed steps
    under load.
    Now Stepper sets up an ESP32 hardware timer at 1 MHz and arms a
    20 µs auto-reload alarm. The timer ISR (timerIsrTrampoline ->
    onTimer) handles all step generation:
    - counts down the current step interval in timer-period ticks
    - issues a STEP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
    [Stepper.cpp, Stepper.h]
2026-05-14 Use Arduino-ESP32 v2.x timer API in Stepper::begin()
    The board package installed is esp32 core 2.0.18 (timerBegin takes
    timer index + divider + countUp; alarm is set with timerAlarmWrite +
    timerAlarmEnable). The v3.x single-frequency signature I had used
    doesn't exist on this core. Switched to the v2.x form:
    timerBegin(0, 80, true) // 80 MHz / 80 = 1 MHz
    timerAttachInterrupt(t, cb, true) // edge-triggered
    timerAlarmWrite(t, period, true) // auto-reload
    timerAlarmEnable(t)
    timerStop(t) // start paused
    [Stepper.cpp]
2026-05-14 Drop speed readout from the display
    The speed line is no longer wanted on the OLED, so remove the
    "S:NN.Nmm/s" segment from Display::showStatus and switch the position
    back to the more readable "Pos: NN mm" form now that the line has room.
    Also tear out the now-dead plumbing rather than leave unused parameters:
    - Display::showStatus loses its spdTenths parameter.
    - Stepper::currentSpeedTenthsMmPerSec() and the lastTargetInterval_ /
    lastWantMove_ members are removed entirely.
    - main.ino's showStatus call is updated to match the new signature.
    [Display.cpp, Display.h, Stepper.cpp, Stepper.h, main.ino]
2026-05-14 Auto-reset the dial to 0 when carriage reaches max travel
    At kMaxPositionSteps (1000 mm) with the dial still in CW territory,
    reset encoderPos to 0 in the main loop. The motor doesn't move (edge
    guard already blocked it), but the dial is now logically neutral, so
    the next CCW click registers as -1 and starts reverse motion
    immediately — no need to wind back through 0 by hand.
    If the user keeps dialing CW at max, each tick gets reset on the next
    loop iteration so the motor stays parked. CCW dialing is unaffected:
    once position drops below max the condition stops firing and the dial
    behaves normally again.
    [main.ino]
2026-05-14 Auto-reset the dial at the home end of travel too
    Mirror the max-travel auto-reset at the soft floor (kMinPositionSteps,
    5 mm): if the carriage is pinned there and the user is still dialing
    CCW, snap encoderPos back to 0 so the next CW click immediately starts
    forward motion. Homing is unaffected — it runs with the encoder ISR
    detached, so this main-loop reset can't fire during it.
    [main.ino]
2026-05-14 Move limit switch from D10 to D12
    Frees D10 and D11 on the Arduino Nano ESP32 for other uses. The limit
    switch only needs INPUT_PULLUP + a falling/level read, which any ESP32-S3
    GPIO supports, so D12 is a drop-in replacement.
    [main.ino]
2026-05-14 Add Motor2 + motor-selection menu
    A second TMC2209-driven stepper is wired on DIR=D8 / STEP=D9. Motor1's
    DIR/STEP, limit switch and homing/long-press-rehome behavior are
    unchanged. The encoder now drives a small mode machine:
    Menu rotation scrolls between "Motor 1" / "Motor 2"
    tap (release < kLongPressMs) selects highlighted item
    Motor1Control existing dial-driven speed + edge guards
    tap returns to menu (motor stops)
    hold past kLongPressMs re-homes (unchanged)
    Motor2Control dial-driven speed bounded to [0°, 180°]
    tap returns to menu (motor stops)
    no homing (motor must be mechanically aligned to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
2026-05-14 Drop display refresh interval from 250 ms to 100 ms
    The 250 ms interval was sized for the pre-timer-driven stepper, when
    display.display()'s ~30 ms blocking I2C frame transfer would starve
    step pulses. Step generation now runs from a hardware-timer ISR, so
    the display block no longer pauses the motor — the 250 ms ceiling on
    visual lag (felt as a delay between turning the dial and the screen
    catching up) is no longer worth the trade.
    At 100 ms the display catches up at 10 fps and the motor remains
    unaffected; the 30 ms block duty rises to ~30% but only steals main-
    loop time, which only matters for the encoder-to-stepper update
    latency (worst case still bounded by one display block, ~30 ms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
    [main.ino]
2026-05-14 Add Motor3 (DIR=D10, STEP=D11) and extend the selection menu
    A third TMC2209-driven stepper, behaviourally identical to Motor2:
    bounded to [0°, 180°], no limit switch, no homing — must be aligned
    to 0° before power-on. Lives in its own class (Motor3.h/.cpp) and
    owns ESP32 hardware timer 2 (Stepper has 0, Motor2 has 1, timer 3
    still free).
    main.ino:
    - Add Mode::Motor3Control to the state machine and a handleMotor3()
    that mirrors handleMotor2 (tap returns to menu; same end-of-travel
    auto-reset trick).
    - Menu now has three items (kMenuItemCount = 3); short-press selects
    via a switch on menuIndex.
    - enterMenu() stops motor3 alongside motor1/motor2.
    Display:
    - showMenu() restructured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
    [Display.cpp, Display.h, Motor3.cpp, Motor3.h, main.ino]
2026-05-14 Strip menu chrome and enlarge the motor entries
    The 'Ember Sensor' header and 'By, Shaurya Varshnay' footer are clutter
    on a screen that's only there to ask 'which motor?'. Removed both, and
    bumped the three menu entries to size-2 text (12x16 px) so the
    highlighted selection is unmistakable from across the bench. The
    remaining 'Select Motor:' header stays at size 1 and the three items
    just fit the 64-pixel panel height (last row ends at y=64 exactly).
    Motor1/2/3 status screens are unchanged — branding is preserved there
    because those screens have less spare vertical space.
2026-05-14 Rename Stepper class and file to Motor1
    Bring the slide motor's class name in line with Motor2 and Motor3.
    - Stepper.h -> Motor1.h, Stepper.cpp -> Motor1.cpp (git tracked as
    renames, content otherwise unchanged).
    - class Stepper -> class Motor1; all member-function definitions,
    static instance pointer, and the four static_asserts updated.
    - main.ino: #include 'Motor1.h', global is now Motor1 motor1(...),
    edge-of-travel auto-reset uses Motor1::kMaxPositionSteps /
    Motor1::kMinPositionSteps.
    - Doc comments in Motor2 and Motor3 that referenced the Stepper class
    by name updated to say Motor1 instead.
    No behavioural change.
    [Motor1.cpp, Motor1.h, Motor2.cpp, Motor2.h, Motor3.cpp, Motor3.h, main.ino]
2026-05-14 Rename motor classes by role: Slider/Pan/Tilt
    Motor1 -> SliderMotor1 (the 1 m slide)
    Motor2 -> PanMotor2 (pan, 0-180°)
    Motor3 -> TiltMotor3 (tilt, 0-180°)
    - Files renamed (git tracks as renames at ~90% similarity):
    Motor1.{h,cpp} -> SliderMotor1.{h,cpp}
    Motor2.{h,cpp} -> PanMotor2.{h,cpp}
    Motor3.{h,cpp} -> TiltMotor3.{h,cpp}
    - Class identifiers renamed inside each file; #include paths updated.
    - main.ino instance variables renamed to match
    (motor1 -> sliderMotor1, motor2 -> panMotor2, motor3 -> tiltMotor3).
    Static member access (Motor1::kMaxPositionSteps etc.) updated.
    - Cross-class doc comments referring to the old names updated.
    Unchanged: pin namespace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
2026-05-14 Use Slider/Pan/Tilt names on the display
    - Menu lists 'Slider-Motor1', 'Pan-Motor2', 'Tilt-Motor3' instead of
    'Motor 1/2/3'. Reverted the menu font back to size 1 because the
    new names don't fit at size 2 ('> Slider-Motor1' is 15 chars =
    180 px wide vs the 128 px panel).
    - Motor 2 / Motor 3 status footers updated to 'Pan-Motor2 [0-180]'
    and 'Tilt-Motor3 [0-180]'.
    - Motor 1 status screen unchanged — it has no motor-name footer
    today (the limit-switch line uses that row), so no rename needed.
    [Display.cpp]
2026-05-16 Extend Pan/Tilt motor range to 360 degrees
2026-05-16 Add All Motors demo mode
2026-05-16 Bound Pan/Tilt to +/-360 and oscillate them in All Motors mode
    [Display.cpp, PanMotor2.cpp, PanMotor2.h, TiltMotor3.cpp, TiltMotor3.h, main.ino]
2026-05-16 All Motors: encoder dial controls slider speed
2026-05-16 Push device state to embersensor.com/api/motor/state
2026-05-18 Honor setSliderSpeed in Motor 1/2/3 modes, not just All Motors
    dispatchRemoteCommand previously gated setSliderSpeed on
    Mode::AllMotorsControl, so clicking Motor 1/2/3 on the website left
    the motor stationary even when a remote setSliderSpeed arrived: the
    device just dropped it. Expand the gate to cover Motor1Control,
    Motor2Control, Motor3Control and AllMotorsControl, which is exactly
    the set of modes where the encoder dial represents a speed setpoint.
    Menu / PanSetup / TiltSetup still ignore the command, where the
    encoder has different semantics (navigation delta, setup nudge) and
    re-anchoring it would surprise the user.
    Encoder::set() already clamps to ±kRange, so no clamping change is
    n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
2026-05-18 Accept nudgePan / nudgeTilt remote commands
    Add two new remote command kinds that move the pan or tilt motor by a
    caller-supplied signed degree delta. The intent is to pair with the
    website's existing Zero Pan / Zero Tilt buttons so the user can align
    the shaft to a physical reference remotely, then click Zero to make
    the firmware agree with reality. Without this, the only way to set a
    non-default zero was the one-shot PanSetup / TiltSetup flow at boot,
    which uses the local encoder and isn't reachable remotely.
    CommandPoller.h
    - New RemoteCmdKind::NudgePan and NudgeTilt.
    - New int deltaDeg field on RemoteCommand for the signed degrees,
    clamped to ±360 upstream by the worker.
    CommandPoll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
2026-05-20 Accept setAllMotorsPanSpeed / setAllMotorsTiltSpeed remote commands
    Convert kAllMotorsPanSpeed / kAllMotorsTiltSpeed from compile-time
    constants to runtime-mutable variables so the website can retune the
    Pan/Tilt bounce magnitudes in All Motors mode. The slider already had
    this via the encoder dial; Pan/Tilt now have parity. Values are clamped
    to [0, Encoder::kRange] in the dispatcher.
2026-05-20 Rename All Motors to Petrol and stop driving tilt in that mode
    The demo mode shown in the menu and on the website is now labeled
    Petrol. Internally the mode key stays "allmotors" so the wire protocol
    is unchanged. The tilt motor no longer bounces in this mode — only the
    slider and pan motors do. Tilt is moved exclusively by the calibration
    commands (nudgeTilt / zeroTilt). The setAllMotorsTiltSpeed remote
    command and its firmware plumbing are removed.
    [CommandPoller.cpp, CommandPoller.h, Display.cpp, Display.h, Encoder.h, main.ino]
2026-05-20 Halve initial pan speed and pre-seed slider speed in Petrol mode
    Pan's default bounce magnitude drops from 12 to 6. Petrol mode now
    seeds the encoder dial to 18 on entry so the slider starts moving as
    soon as the user selects Petrol instead of sitting at zero until the
    dial is spun.
2026-10-05 Add MLX90640 thermal camera USB test sketch and browser viewer
    Standalone bring-up sketch streams 32x24 thermal frames over USB serial
    from a dedicated I2C bus (Wire1 on A0/A1). A Web Serial viewer renders
    the live heatmap in Chrome. Includes a setup guide with wiring, power,
    mounting notes, and a step-by-step first test. Motor firmware unchanged.
    Refs shauryarchs/embersensor-site#46
2026-10-05 Run thermal camera in main firmware and report hotspots over serial
    Adds a ThermalCamera module that reads the MLX90640 on Wire1 (A0/A1)
    in a core-0 FreeRTOS task, finds the hot blob's temperature-weighted
    centroid, smooths and debounces it against flame flicker, and prints
    a THERMAL status line to the Serial Monitor about once per second.
    Display only: no motor movement or water. Retries quietly when the
    camera is absent. Setup guide gains Phase 2 test steps, tuning, and
    arm-mounting guidance.
    Refs shauryarchs/embersensor-site#49
2026-10-05 Rename Petrol mode to Patrol (spelling)
    Display labels, comments, and one firmware constant only. The wire
    value "allmotors" is unchanged, so there is no API change.
    Refs shauryarchs/embersensor-site#54
2026-10-05 Mirror thermal dx to match camera's point of view
    Hardware test showed the MLX90640's raw image is mirrored left-right:
    a heat source on the camera's right reported dx < 0. Set kFlipX so
    right of center is positive. Up/down was already correct.
    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
    [ThermalCamera.h]
2026-10-11 Add thermal auto-aim test mode: slide first, then pan/tilt
    AutoAim centers a confirmed thermal hotspot with a stop-and-look loop.
    Horizontal error is fixed by sliding along the rail first; probe slides
    measure the hotspot's shift per mm, which sizes later slides and gives a
    triangulated distance. Pan is used only at the end of the rail or when
    sliding no longer changes the view. Tilt handles up/down, and pan
    corrections invert when tilt faces the camera backward.
    Off at every boot; enabled with 'aim on' in the Serial Monitor and only
    active at the menu. Any encoder input, mode change, or remote command
    stops its motion and pauses it. All moves go through the motors' own
    update() limits (sli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
2026-10-11 Probe the other slide direction when the guessed one has no room
    Hardware test: with the carriage parked at the home switch after boot
    and the first-probe direction guessed backwards for how the camera is
    mounted, the probe had no room, so auto-aim skipped sliding and aimed
    with pan only. Until the slide direction has been measured, probe the
    opposite way instead; the measurement then fixes the direction.
    Refs shauryarchs/embersensor-site#52
2026-10-11 Return pan to 0 before sliding; never auto-disable auto-aim
    When the next correction can be made by sliding (slider has room toward
    the hotspot), pan is first returned to 0 degrees, then the carriage
    slides. The decision uses the hotspot's bearing from the rail normal
    (pan angle + dx) so it doesn't flip-flop; if returning pan would put the
    hotspot out of view (> ~50 degrees), it slides first. Pan returns are
    excluded from the wrong-way check.
    A second wrong-way pan/tilt move now pauses for 5 s instead of turning
    auto-aim off. Only 'aim off' disables it.
    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
2026-10-12 Enable thermal auto-aim at boot
    Auto-aim now starts on (AutoAim::kEnabledAtBoot = true) instead of
    requiring 'aim on' after every boot. It still acts only at the menu,
    so nothing moves during the boot pan/tilt setup screens; any user input
    pauses it, and 'aim off' disables it until the next reboot. Prints
    'AIM on at boot' once Serial is up. No water yet.
    Refs shauryarchs/embersensor-site#56
2026-10-25 Spray water when auto-aim is on target
    Add a Sprayer module that drives the pump relay from D2 through an NPN
    transistor. With automatic spraying enabled ('spray on', off at boot),
    the pump starts when auto-aim reports on-target, keeps running while aim
    stays engaged, and stops when the target is lost, aim pauses or is
    turned off, on any encoder or website input, or after 60 s (then a 10 s
    cooldown). Manual 'pump on [s]' / 'pump off' for testing.
    Serial line reading moves from AutoAim into main.ino so aim, spray and
    pump commands share it.
    Refs shauryarchs/embersensor-site#53
2026-10-25 Enable automatic spraying at boot
    Owner validated spraying on target on the main board and signed off on
    turning it on at boot. 'spray off' still disables it until reboot.
    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
2026-10-25 Park the slider at the centre of the rail after homing
    After boot homing and after any re-home (Motor 1 long-press or the
    website's Rehome), move the carriage to the middle of its travel
    (490 mm) so the thermal camera's 110 deg view covers both sides of the
    rail. New SliderMotor1::moveToBlocking() uses the homing step path at
    the homing fast speed (about 16 s for the move).
    Refs shauryarchs/embersensor-site#58
2026-10-26 Start and stop the pump from remote commands
    Handle pumpOn (timed manual run, capped at kRemoteMaxS = 10 s) and pumpOff from the Worker, and report pumpOn in the state push. Remote mode, speed and nudge commands now stop only automatic spraying, so a manual spray keeps running while the user aims; pumpOff and Stop (enterMode menu) end it. Encoder input still stops all water. The serial pump on command keeps its 1-30 s range.
2026-11-02 Document the 12 V solenoid valve and hose that replaced the pump
    Update the wiring, power and test notes in THERMAL_CAMERA.md and the
    hardware comment in Sprayer.h. Comments and docs only; no firmware change.
    Refs shauryarchs/embersensor-site#72
2026-11-02 Match the documented solenoid wiring to the rig
    The 12 V lane goes to relay NO and relay COM to the solenoid. Add the
    adapter connection and the capacitor across the 12 V lanes.
    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
2026-11-08 Add main PCB design, fab files and build checklist
    Copies the breadboard rig onto one 190 x 102 mm two-layer board: Nano ESP32,
    three TMC2209 drivers, relay control transistor, 1N5408 flyback diode, 5 A fuse
    and the 100 uF 12 V capacitor, with the OLED and encoder soldered in the
    upper left. Includes the schematic and PCB generators, a netlist check against
    main.ino, gerbers, a 1:1 fit-check print, the parts list and a build checklist.
2026-11-14 Decode the encoder with a quadrature state machine
    Interrupt on every CLK and DT change, follow the full quadrature sequence
    with a transition table that ignores bounce and impossible jumps, and count
    one step when the knob settles on a detent. Removes the 1.5 ms CLK lockout
    that dropped fast turns and the single DT sample that bounce could flip.
    Public API, direction and the ±kRange clamp are unchanged.
